NgThachThanh/smart-helmet/docs/app1.png

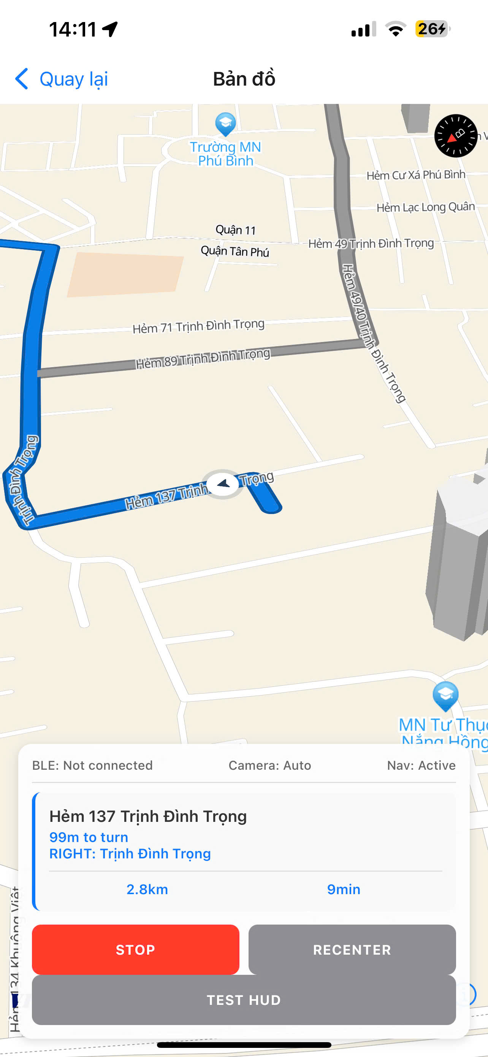
docs/app1.png
