NgThachThanh/smart-helmet/docs/app2.png

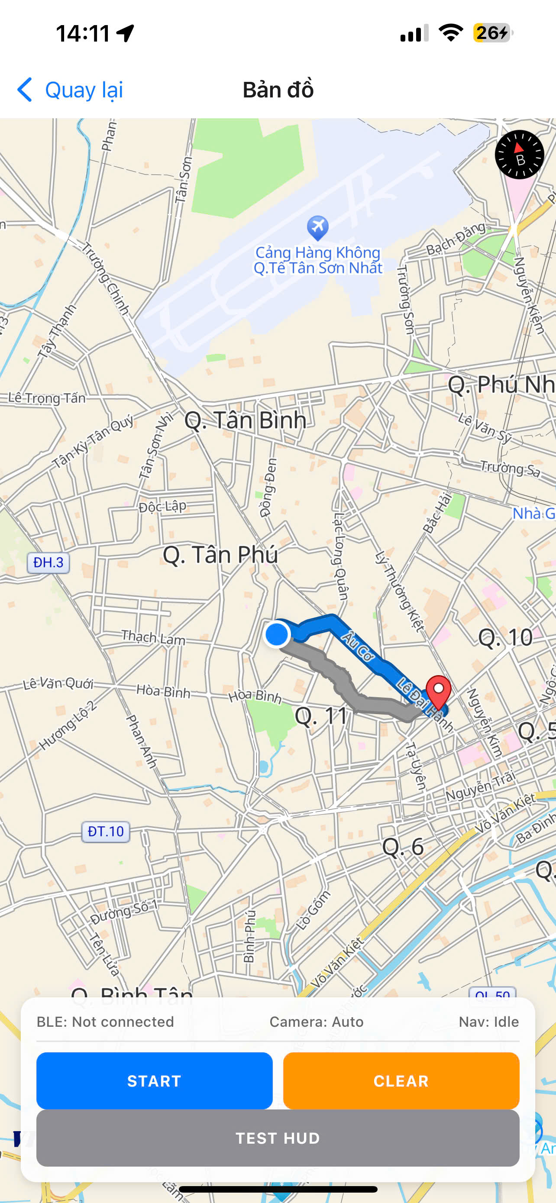
docs/app2.png
