NgThachThanh/smart-helmet/docs/app3.png

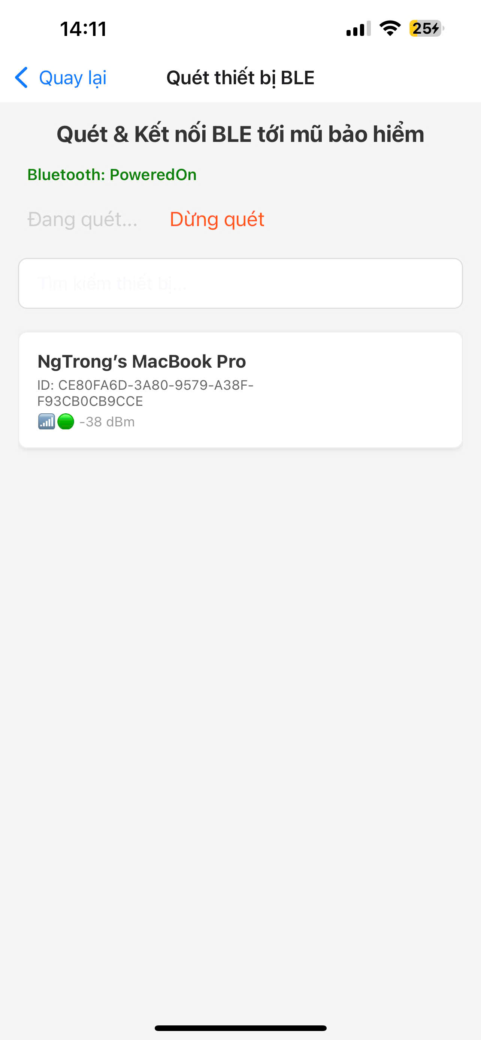
docs/app3.png
