NgThachThanh/smart-helmet/docs/app4.png

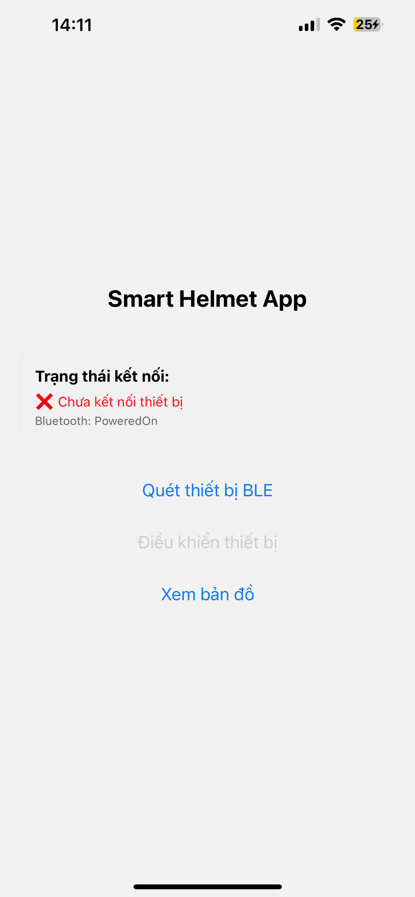
docs/app4.png
