NgThachThanh/smart-helmet/docs/Helmet.png

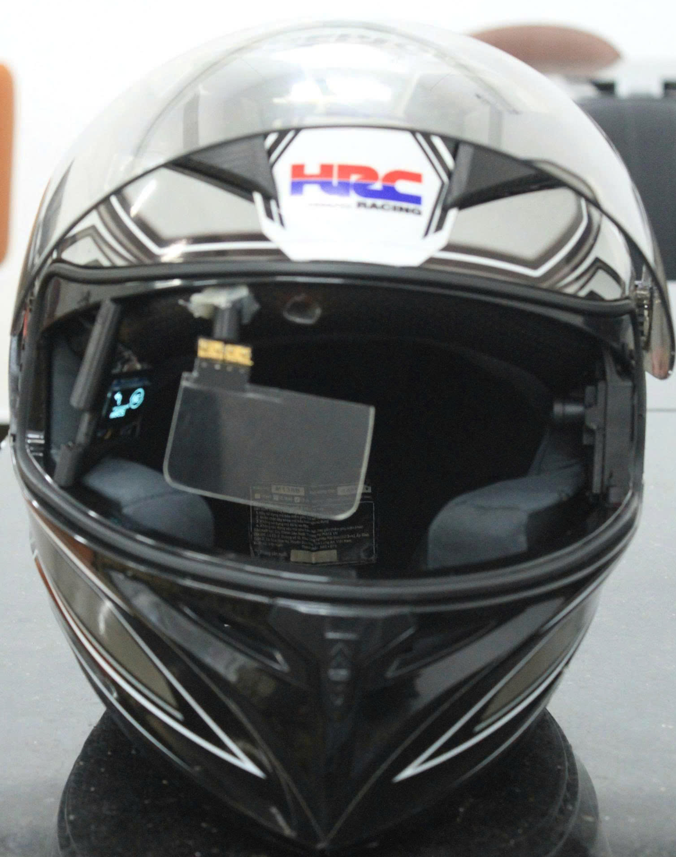
docs/Helmet.png
