NgThachThanh/smart-helmet/docs/p7.png

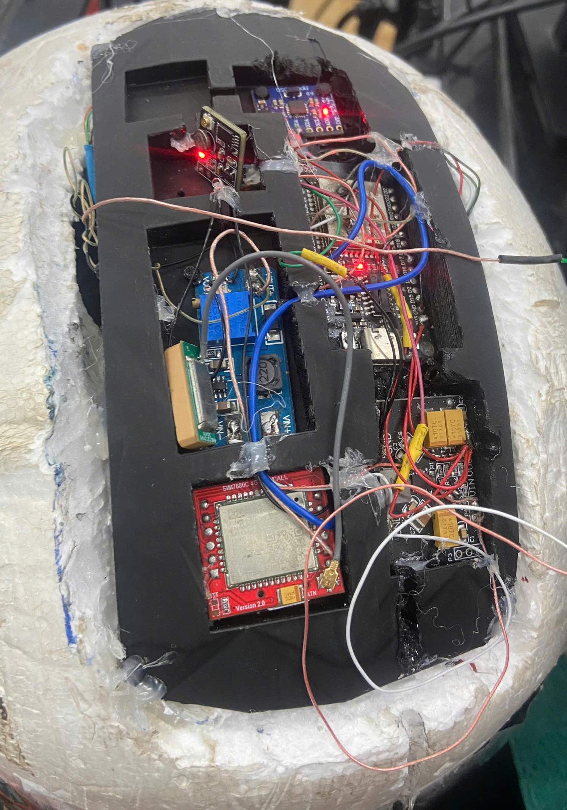
docs/p7.png
