NgThachThanh/smart-helmet/docs/sms.png

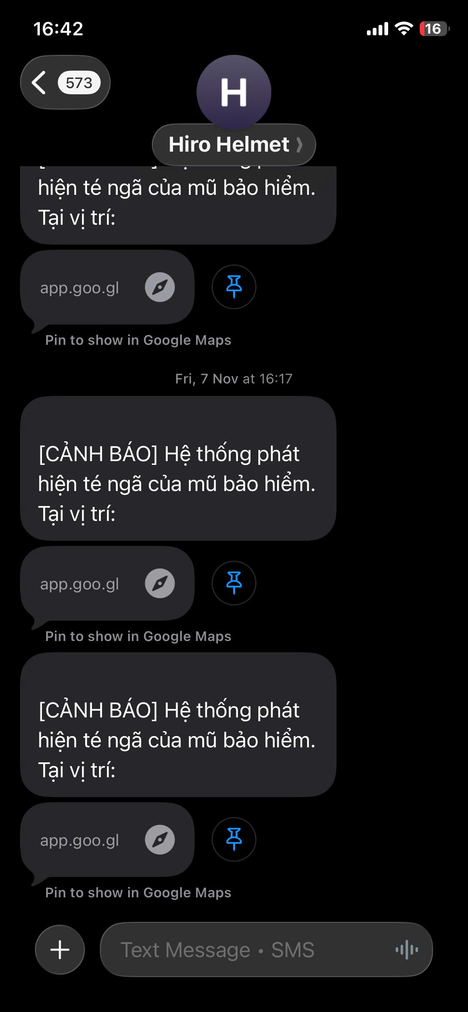
docs/sms.png
