NgThachThanh/smart-helmet/docs/sos2.png

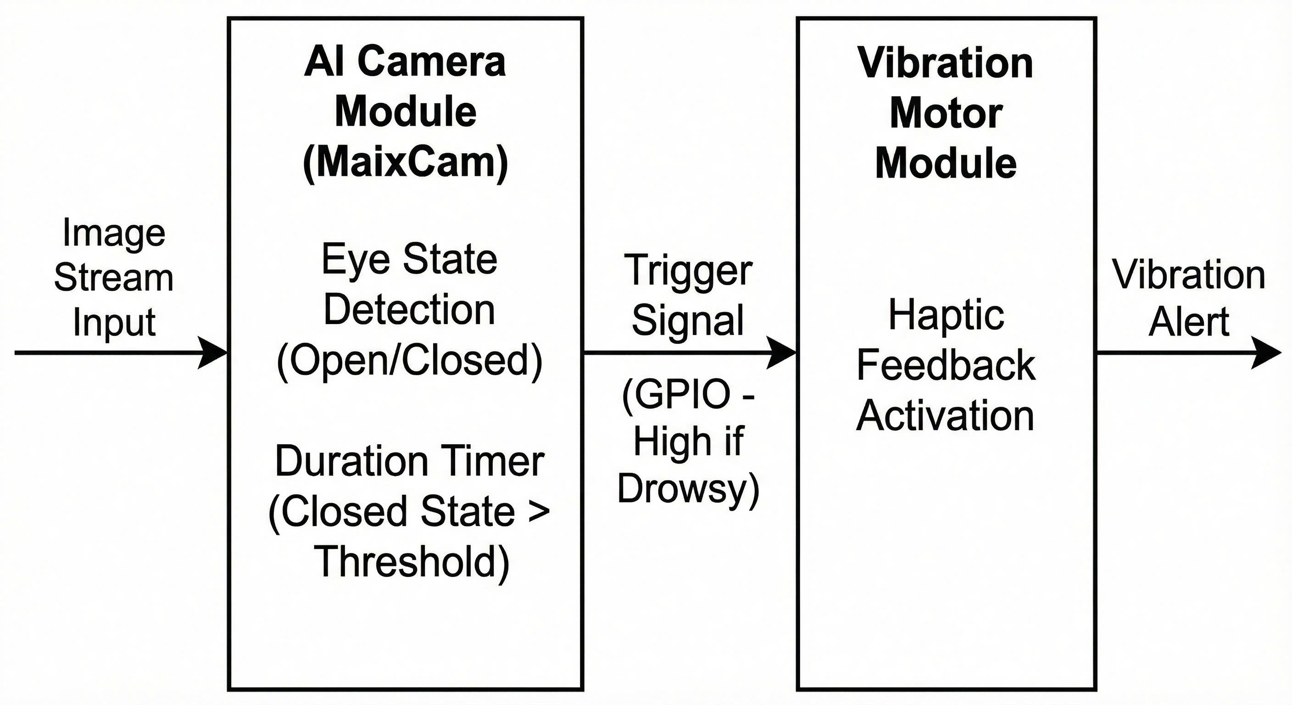
docs/sos2.png
