NgThachThanh/smart-helmet/docs/system_arch.png

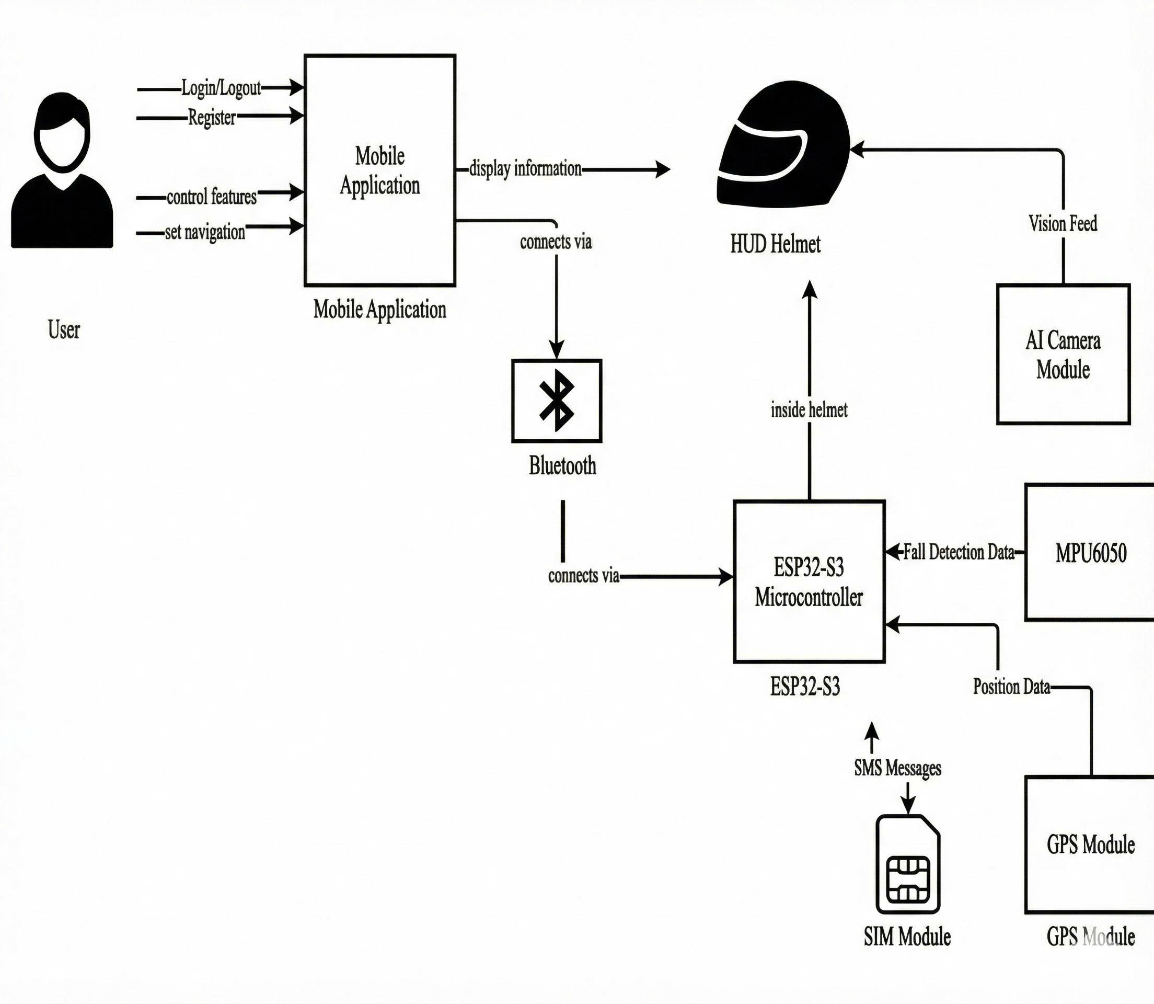
docs/system_arch.png
