NgThachThanh/smart-helmet/(commit log)

2026-08-31 Smart Helmet: ESP32-S3 firmware — fall detection, BLE HUD, SOS SMS
    - Multi-evidence fall detection: MPU6050 @100Hz, Kalman + complementary
    filter, 3-stage state machine (impact/tilt -> 3s recovery -> 10s countdown)
    - SOS: ATGM336H GPS (NMEA) + SIM A7680C SMS with Google Maps link
    - HUD: SSD1306 OLED + BLE server, JSON navigation from React Native app
    - FreeRTOS multi-core tasks; builds with PlatformIO (espressif32)
2026-08-31 Dịch README sang tiếng Việt, bỏ phần hướng dẫn build
2026-08-31 Thêm mục thành tích vào README
2026-08-31 Sửa bố cục README: ảnh kiến trúc về sau mở đầu, thành tích xuống dưới
